gradybos/smart-moisture-monitor/images/pcbphysical.png

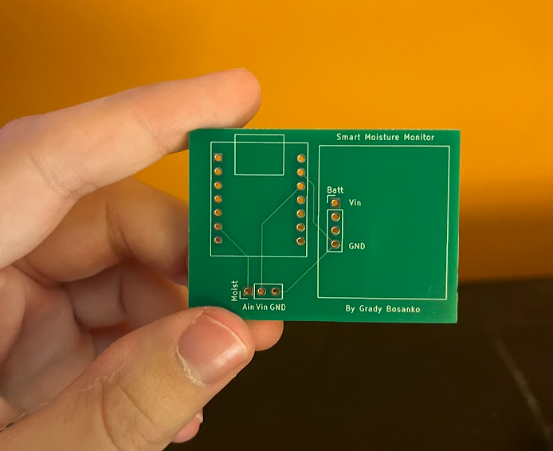
images/pcbphysical.png
