gradybos/smart-moisture-monitor/(commit log)

2026-10-02 Added ADC sensor readings
2026-11-03 improved power management
2026-11-11 made flow charts
